shipshape-marine/solar_proa_network_server/images/Monitoring Application/gps_tab.jpg

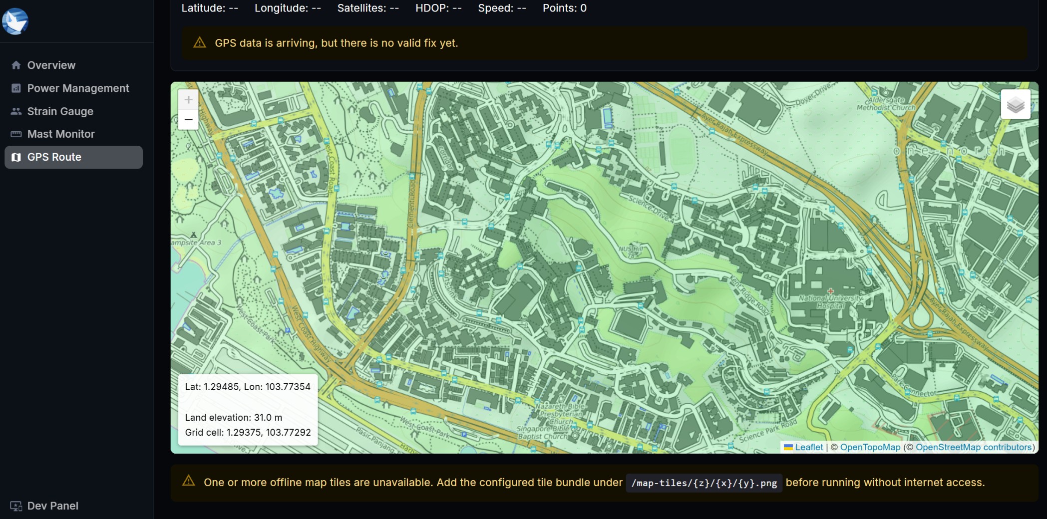
images/Monitoring Application/gps_tab.jpg
