shipshape-marine/solar_proa_network_server/images/Monitoring Application/imu_tab.jpg

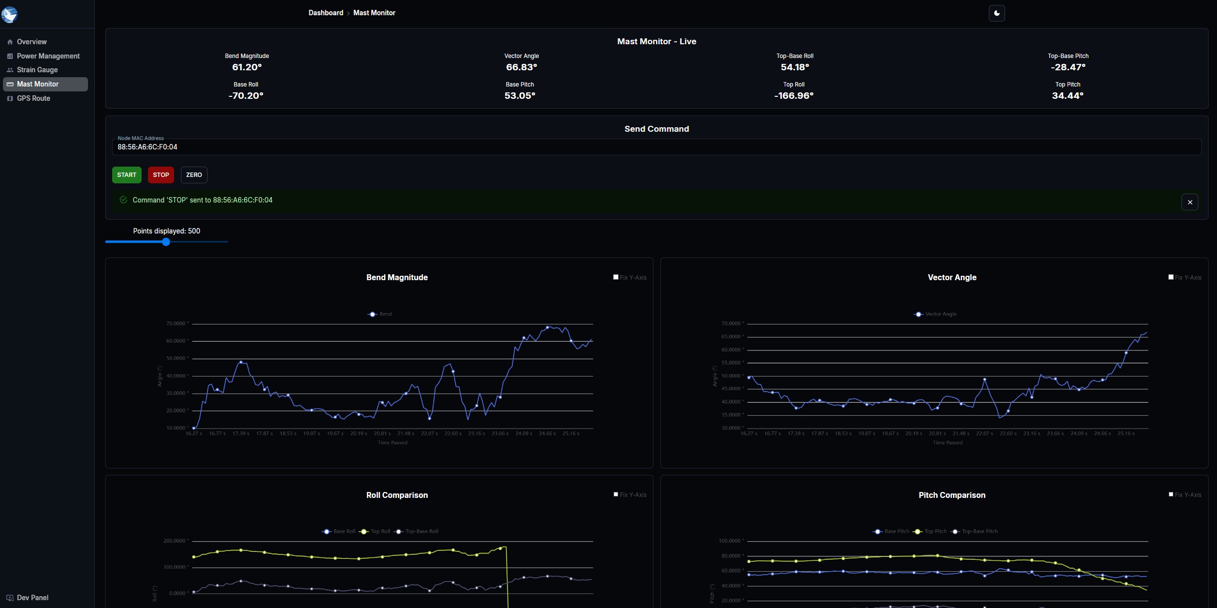
images/Monitoring Application/imu_tab.jpg
