shipshape-marine/solar_proa_network_server/images/Monitoring Application/power_tab.jpg

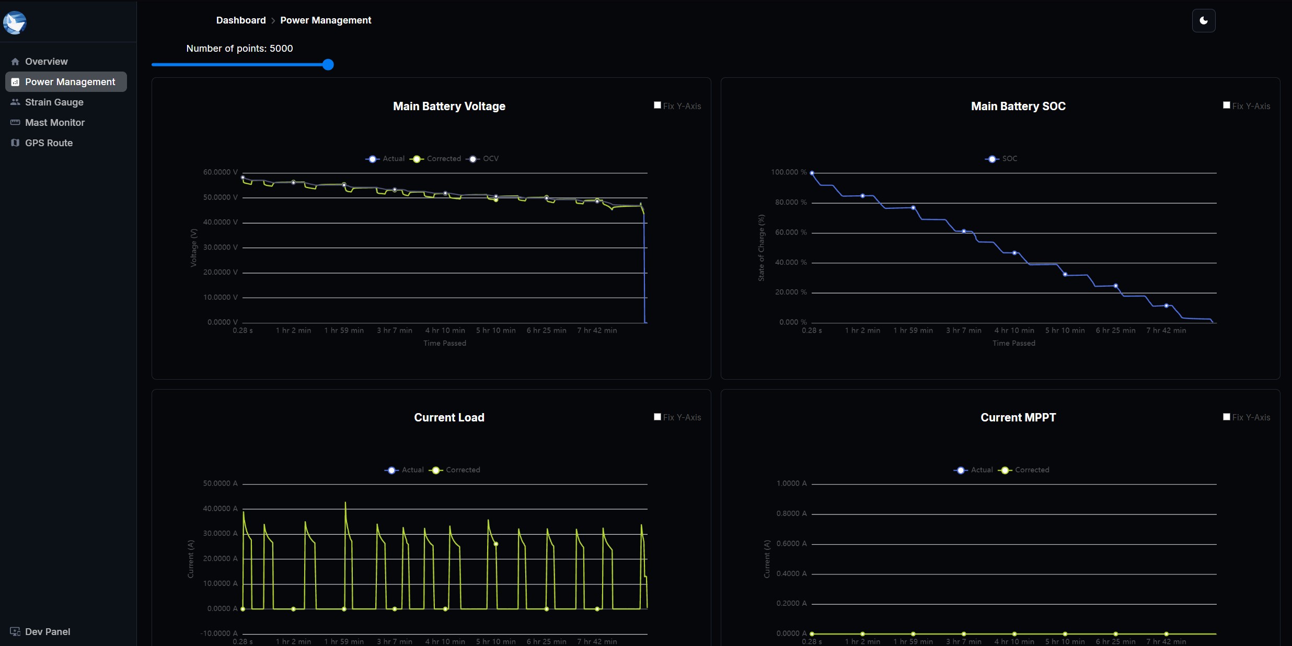
images/Monitoring Application/power_tab.jpg
