shipshape-marine/solar_proa_network_server/images/Monitoring Application/strain_tab.jpg

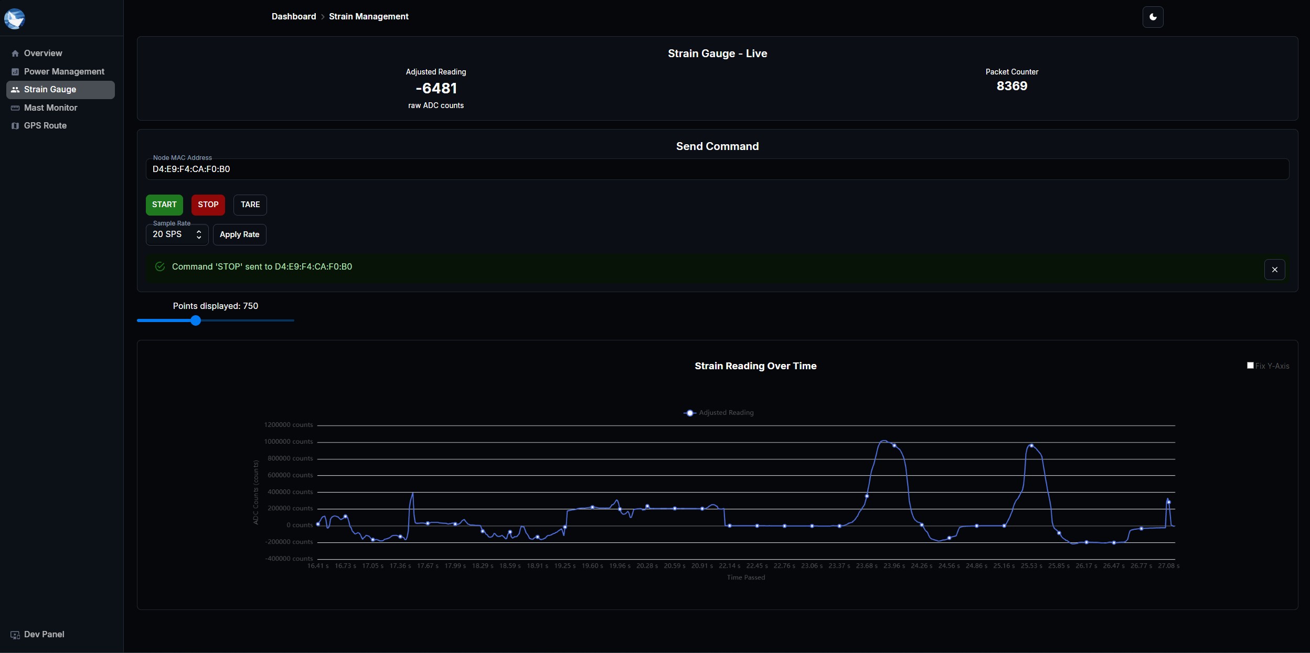
images/Monitoring Application/strain_tab.jpg
