shipshape-marine/solar_proa_network_server/images/Poster/FYP-IP-01 Solar Proa A1 Poster.png

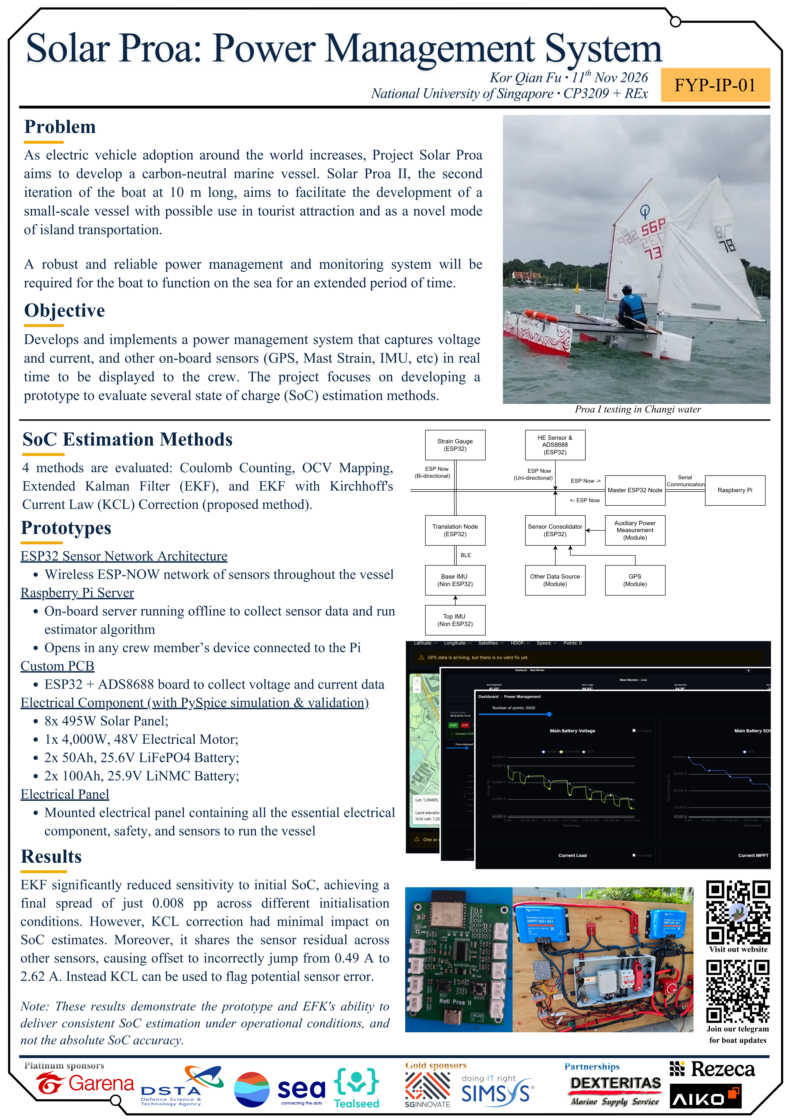
images/Poster/FYP-IP-01 Solar Proa A1 Poster.png
