shipshape-marine/solar_proa_network_server/proa_advisor/model/bathymetry/gebco_2026_n1.9_s1.0_w102.7_e104.3_png_cm.png

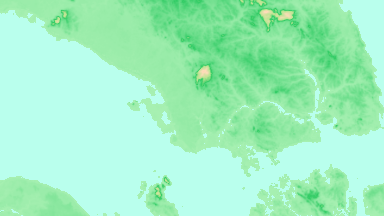
proa_advisor/model/bathymetry/gebco_2026_n1.9_s1.0_w102.7_e104.3_png_cm.png
