shipshape-marine/solar_proa_network_server/images/Power Management PCB/soldered_board.jpg

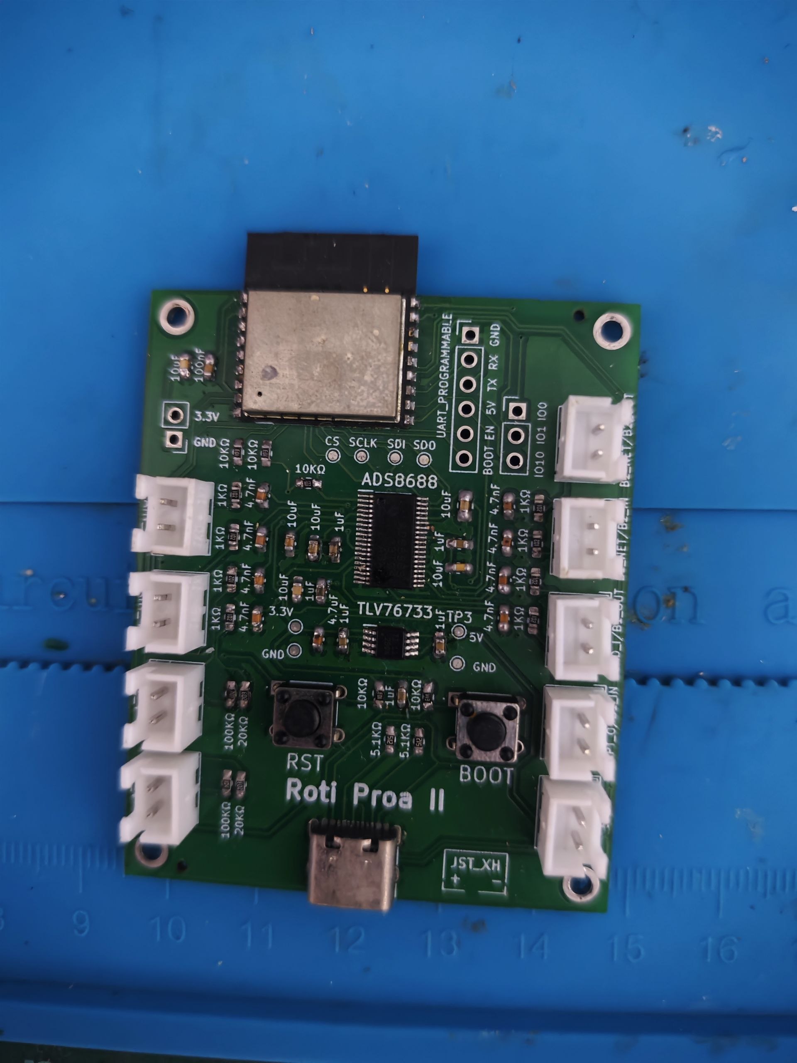
images/Power Management PCB/soldered_board.jpg
