shipshape-marine/solar_proa_network_server/final_report/Calibration Code/README.md

# NOTE

Download Patch output for LiFePO4 and LiMNC from the [repository](https://github.com/shipshape-marine/2rc-ekf-battery-state-estimation) before running any code. They are not commited due to the file size

Sync any modification with calibration code in the original repo above. Code is pasted here for easier tuning aand report analysis.
