shipshape-marine/solar_proa_network_server/proa_advisor/model/battery_model/test_data/LiFePO4 Controlled Discharge/data_20260525-115441.csv

counter | timediff_us | ch0 | ch1 | ch2 | ch3 | ch4 | ch5 | ch6 | ch7
1 | 48860088 | 32768 | 32738 | 32737 | 32762 | 32764 | 32767 | 55913 | 1
2 | 942 | 32768 | 32730 | 32755 | 32764 | 32764 | 32766 | 55914 | 0
3 | 938 | 32768 | 32715 | 32756 | 32762 | 32763 | 32766 | 55913 | 0
4 | 939 | 32768 | 32703 | 32723 | 32763 | 32764 | 32767 | 55914 | 1
5 | 938 | 32768 | 32722 | 32731 | 32763 | 32764 | 32765 | 55914 | 0
6 | 942 | 32768 | 32749 | 32766 | 32762 | 32764 | 32766 | 55915 | 4
7 | 938 | 32768 | 32730 | 32737 | 32763 | 32764 | 32766 | 55914 | 0
8 | 939 | 32768 | 32718 | 32693 | 32763 | 32764 | 32767 | 55914 | 1
9 | 938 | 32768 | 32699 | 32745 | 32763 | 32765 | 32767 | 55915 | 0
10 | 938 | 32768 | 32714 | 32761 | 32762 | 32764 | 32766 | 55914 | 1
11 | 943 | 32768 | 32713 | 32730 | 32762 | 32765 | 32767 | 55913 | 0
12 | 938 | 32768 | 32750 | 32735 | 32762 | 32765 | 32766 | 55914 | 0
13 | 938 | 32768 | 32705 | 32763 | 32762 | 32764 | 32766 | 55915 | 0
14 | 939 | 32768 | 32694 | 32744 | 32762 | 32764 | 32765 | 55914 | 0
15 | 938 | 32768 | 32718 | 32701 | 32763 | 32765 | 32766 | 55914 | 0
16 | 942 | 32768 | 32739 | 32752 | 32763 | 32764 | 32766 | 55914 | 0
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
