shipshape-marine/solar_proa_network_server/TODO.md

1. External controller? using esp32 control box
