shipshape-marine/solar_proa_network_server/Hardware Schematics/Electrical Schematics/Final Design/Final Design.kicad_sch

## KiCad design Hardware Schematics/Electrical Schematics/Final Design/Final Design.kicad_sch (2026-11-06)

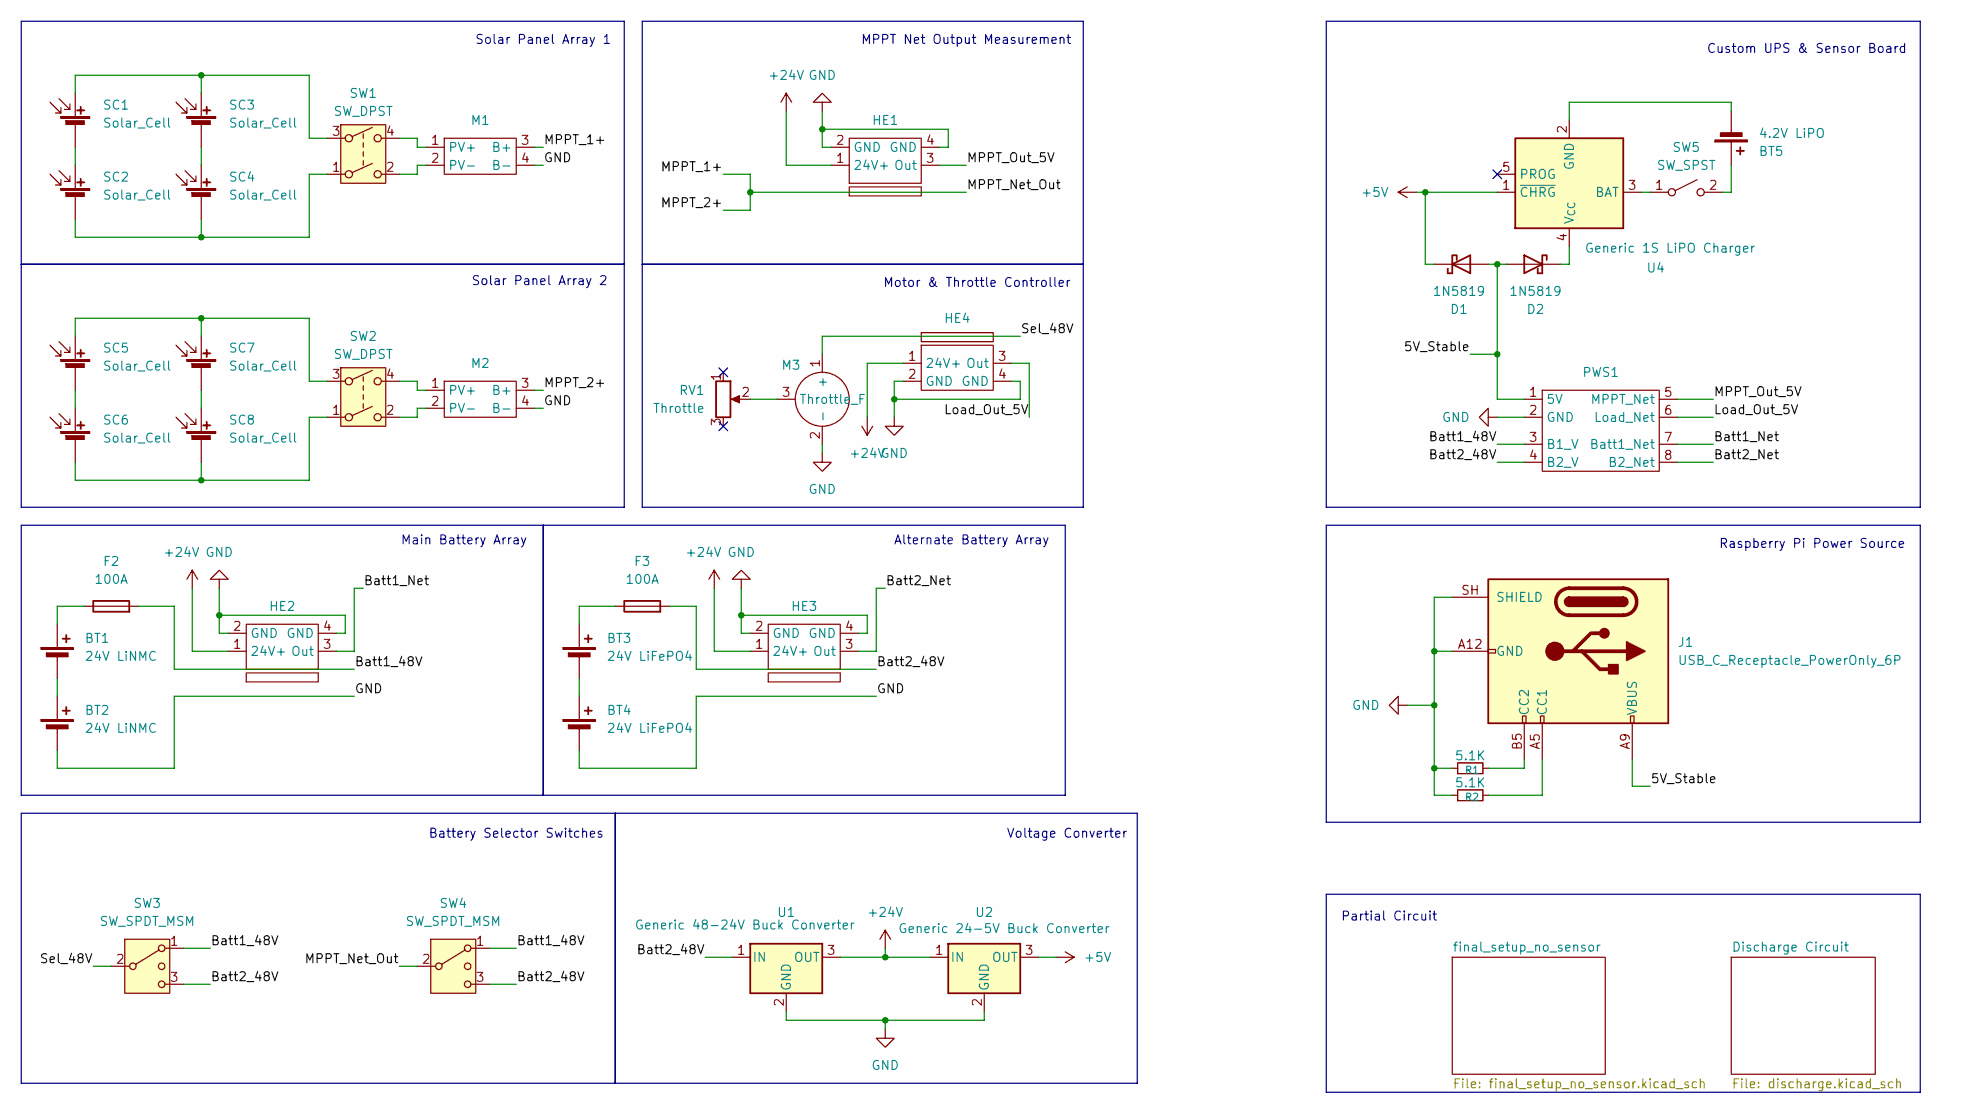
[picture p35: schematic Final Design.kicad_sch]

Parts:
BT1, BT2: 24V LiNMC
BT3, BT4: 24V LiFePO4
BT5: 4.2V LiPO
D1, D2: 1N5819; D_DO-41_SOD81_P10.16mm_Horizontal
F2, F3: 100A
HE1, HE2, HE3, HE4: (no value)
J1: USB_C_Receptacle_PowerOnly_6P
M1, M2, M3: (no value)
PWS1: (no value)
R1, R2: 5.1K
RV1: Throttle
SC1, SC2, SC3, SC4, SC5, SC6, SC7, SC8: Solar_Cell
SW1, SW2: SW_DPST
SW3, SW4: SW_SPDT_MSM
SW5: SW_SPST
U1: Generic 48-24V Buck Converter; Converter_DCDC_RECOM_R-78HB-0.5_THT
U2: Generic 24-5V Buck Converter; Converter_DCDC_RECOM_R-78B-2.0_THT
U4: Generic 1S LiPO Charger; TSOT-23-5

Connections:
5V_Stable: D1.2 (A), D2.2 (A), J1.A9 (VBUS), J1.B9 (VBUS), PWS1.1 (5V)
+5V: D1.1 (K), U2.3 (OUT), U4.1 (~CHRG)
+24V: HE1.1 (24V+), HE2.1 (24V+), HE3.1 (24V+), HE4.1 (24V+), U1.3 (OUT), U2.1 (IN)
Batt1_48V: F2.2, PWS1.3 (B1_V), SW3.1, SW4.1
Batt1_Net: HE2.3 (Out), PWS1.7 (Batt1_Net)
Batt2_48V: F3.2, PWS1.4 (B2_V), SW3.3 (4), SW4.3 (4), U1.1 (IN)
Batt2_Net: HE3.3 (Out), PWS1.8 (B2_Net)
GND: BT2.2 (-), BT4.2 (-), HE1.2 (GND), HE1.4 (GND), HE2.2 (GND), HE2.4 (GND), HE3.2 (GND), HE3.4 (GND), HE4.2 (GND), HE4.4 (GND), J1.A12 (GND), J1.B12 (GND), J1.SH (SHIELD), M1.4 (B-), M2.4 (B-), M3.2 (-), PWS1.2 (GND), R1.1, R2.1, U1.2 (GND), U2.2 (GND)
Load_Out_5V: HE4.3 (Out), PWS1.6 (Load_Net)
MPPT_1+: M1.3 (B+), M2.3 (B+), SW4.2 (3)
MPPT_Out_5V: HE1.3 (Out), PWS1.5 (MPPT_Net)
unnamed: BT1.1 (+), F2.1
unnamed: BT1.2 (-), BT2.1 (+)
unnamed: BT3.1 (+), F3.1
unnamed: BT3.2 (-), BT4.1 (+)
unnamed: BT5.1 (+), SW5.2 (B)
unnamed: BT5.2 (-), U4.2 (GND)
unnamed: D2.1 (K), U4.4 (V_{CC})
unnamed: J1.A5 (CC1), R2.2
unnamed: J1.B5 (CC2), R1.2
unnamed: M1.1 (PV+), SW1.4
unnamed: M1.2 (PV-), SW1.2
unnamed: M2.1 (PV+), SW2.4
unnamed: M2.2 (PV-), SW2.2
unnamed: M3.3 (Throttle_F), RV1.2
unnamed: SC1.1 (+), SC3.1 (+), SW1.3
unnamed: SC1.2 (-), SC2.1 (+)
unnamed: SC2.2 (-), SC4.2 (-), SW1.1
unnamed: SC3.2 (-), SC4.1 (+)
unnamed: SC5.1 (+), SC7.1 (+), SW2.3
unnamed: SC5.2 (-), SC6.1 (+)
unnamed: SC6.2 (-), SC8.2 (-), SW2.1
unnamed: SC7.2 (-), SC8.1 (+)
unnamed: SW5.1 (A), U4.3 (BAT)
Sel_48V: M3.1 (+), SW3.2 (3)

Notes on the sheet:
Voltage Converter
Main Battery Array
Custom UPS & Sensor Board
Solar Panel Array 1
Raspberry Pi Power Source
Battery Selector Switches
Solar Panel Array 2
Partial Circuit
Alternate Battery Array
Motor & Throttle Controller
MPPT Net Output Measurement
