shipshape-marine/solar_proa_network_server/Hardware Schematics/Electrical Schematics/Final Design/discharge.kicad_sch

## KiCad design Hardware Schematics/Electrical Schematics/Final Design/discharge.kicad_sch (2026-10-28)

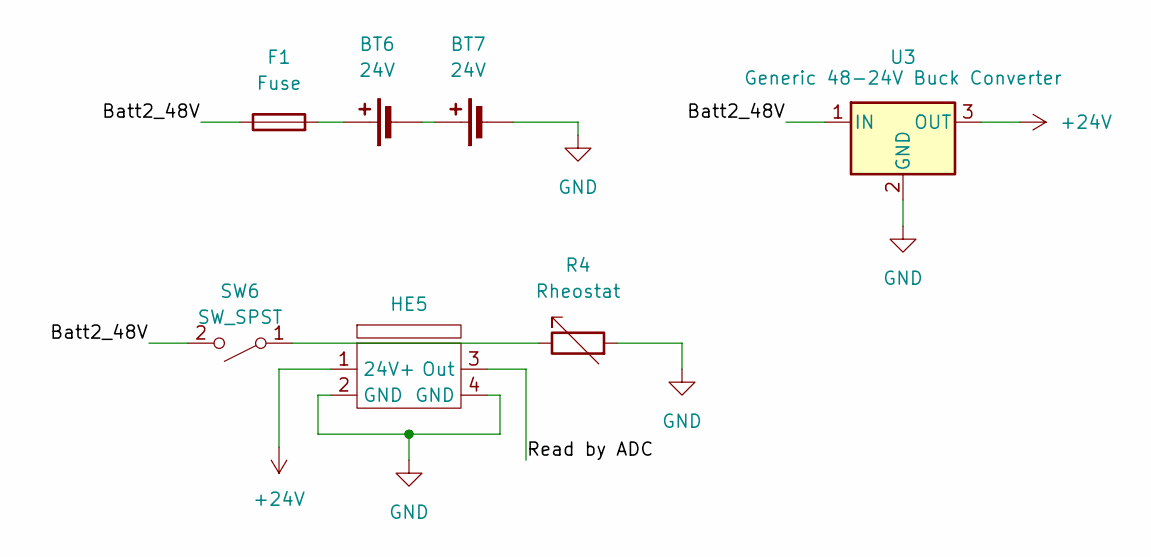
[picture p36: schematic discharge.kicad_sch]

Parts:
BT6, BT7: 24V
F1: Fuse
HE5: (no value)
R4: Rheostat
SW6: SW_SPST
U3: Generic 48-24V Buck Converter; Converter_DCDC_RECOM_R-78HB-0.5_THT

Connections:
+24V: HE5.1 (24V+), U3.3 (OUT)
Batt2_48V: F1.1, SW6.2 (B), U3.1 (IN)
GND: BT7.2 (-), HE5.2 (GND), HE5.4 (GND), R4.2, U3.2 (GND)
unnamed: BT6.1 (+), F1.2
unnamed: BT6.2 (-), BT7.1 (+)
unnamed: R4.1, SW6.1 (A)
Read by ADC: HE5.3 (Out)
