shipshape-marine/solar_proa_network_server/Hardware Schematics/Electrical Schematics/Final Design/final_setup_no_sensor.kicad_sch

## KiCad design Hardware Schematics/Electrical Schematics/Final Design/final_setup_no_sensor.kicad_sch (2026-10-28)

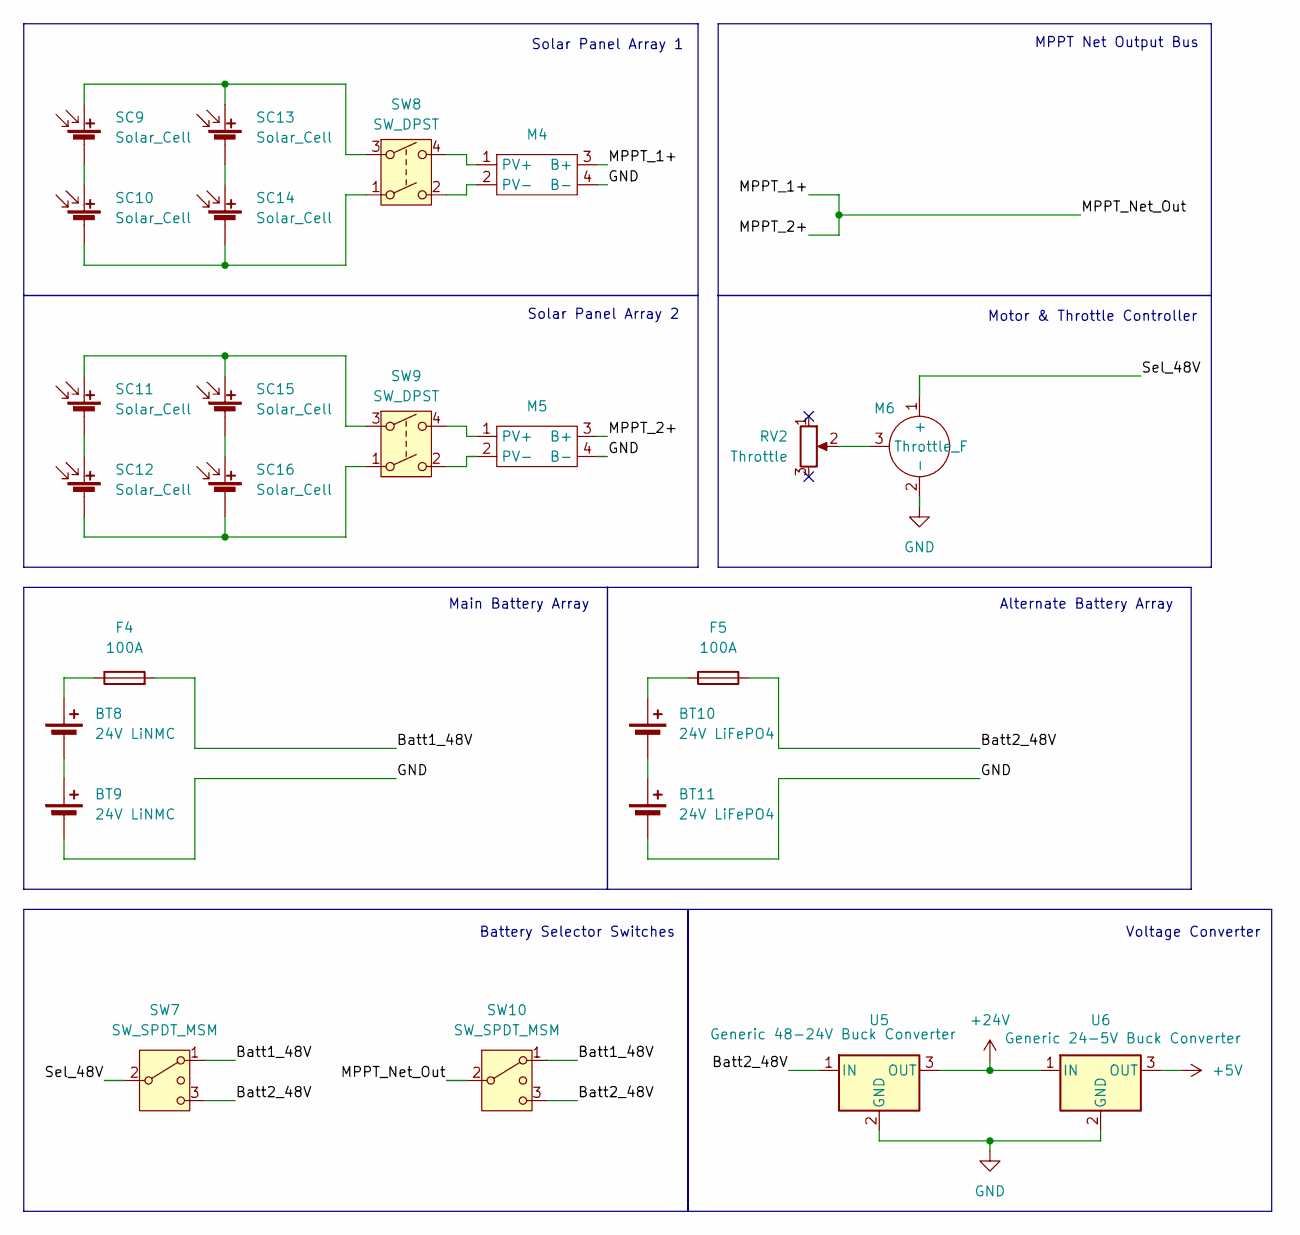
[picture p37: schematic final_setup_no_sensor.kicad_sch]

Parts:
BT8, BT9: 24V LiNMC
BT10, BT11: 24V LiFePO4
F4, F5: 100A
M4, M5, M6: (no value)
RV2: Throttle
SC9, SC10, SC11, SC12, SC13, SC14, SC15, SC16: Solar_Cell
SW7, SW10: SW_SPDT_MSM
SW8, SW9: SW_DPST
U5: Generic 48-24V Buck Converter; Converter_DCDC_RECOM_R-78HB-0.5_THT
U6: Generic 24-5V Buck Converter; Converter_DCDC_RECOM_R-78B-2.0_THT

Connections:
+5V: U6.3 (OUT)
+24V: U5.3 (OUT), U6.1 (IN)
Batt1_48V: F4.2, SW7.1, SW10.1
Batt2_48V: F5.2, SW7.3 (4), SW10.3 (4), U5.1 (IN)
GND: BT9.2 (-), BT11.2 (-), M4.4 (B-), M5.4 (B-), M6.2 (-), U5.2 (GND), U6.2 (GND)
MPPT_1+: M4.3 (B+), M5.3 (B+), SW10.2 (3)
unnamed: BT8.1 (+), F4.1
unnamed: BT8.2 (-), BT9.1 (+)
unnamed: BT10.1 (+), F5.1
unnamed: BT10.2 (-), BT11.1 (+)
unnamed: M4.1 (PV+), SW8.4
unnamed: M4.2 (PV-), SW8.2
unnamed: M5.1 (PV+), SW9.4
unnamed: M5.2 (PV-), SW9.2
unnamed: M6.3 (Throttle_F), RV2.2
unnamed: SC9.2 (-), SC10.1 (+)
unnamed: SC10.2 (-), SC14.2 (-), SW8.1
unnamed: SC11.1 (+), SC15.1 (+), SW9.3
unnamed: SC11.2 (-), SC12.1 (+)
unnamed: SC12.2 (-), SC16.2 (-), SW9.1
unnamed: SC9.1 (+), SC13.1 (+), SW8.3
unnamed: SC13.2 (-), SC14.1 (+)
unnamed: SC15.2 (-), SC16.1 (+)
Sel_48V: M6.1 (+), SW7.2 (3)

Notes on the sheet:
Solar Panel Array 2
Voltage Converter
Solar Panel Array 1
MPPT Net Output Bus
Battery Selector Switches
Alternate Battery Array
Main Battery Array
Motor & Throttle Controller
