shipshape-marine/solar_proa_network_server/(commit log)

2026-09-28 backend fetching of strain and imu mac address
2026-09-29 update power management file name
2026-10-18 remove unecessary variables in filter
2026-10-28 update circuit diagram to include discharge test setup
2026-10-28 added missing fuse for battery terminal and seperate sensor diagrams
2026-10-29 fix data recovery on reload or tab switch
2026-10-29 fix current revere flag not reverting and toggleable offset & kcl correction
2026-11-06 update schematics
2026-11-06 update battery state
2026-11-07 include calibration and 2rc extraction code for report analysis
2026-11-08 reverse game mode switch battery
